parker-research/yagi-flower-antenna/README.md

# yagi-flower-antenna

A group of UHF yagi antennas, arranged in a flower pattern and connected with a SP8T RF switch, to enable coarse beam direction control (like an antenna rotator, but solid-state).

The technical name for this not-all-that-novel approach is "faceted/switched-element array".

## Status

In development. Expected completion: 2026-12-01.

## Parts

1. Antennas (6x yagi antennas, approx. 7 dBi each)
2. Structural mount for antennas (see [`mechanical/`](mechanical/README.md))
3. SP8T RF switch PCB
    - Microcontroller
    - SP8T RF switch IC (SKY13418)
    - LNAs between each antenna port and the RF switch
    - SMA ports to each antenna + common
    - 3D-printed enclosure (see [`mechanical/`](mechanical/README.md))
4. Firmware for PCB microcontroller, masquerading as an antenna rotator (see [`firmware/`](firmware/README.md))
5. Cables to each antenna

## Why?

Satellite tracking works best with a directional antenna: less ambient noise/interference, and higher gain.

However, mechanical antenna rotators are expensive and wear out over time. They require zeroing/calibration, especially after power outages. There are no high-quality open source/DIY designs available. Cheap rotators (e.g., AntRunner) fail in weatherproofing.

This project aims to solve these problems by providing a low-cost, high-quality, open source/DIY, solid-state replacement for a traditional mechanical antenna rotator.

Consider an antenna being deployed in a remote location, like the arctic. As far as I can tell, this yagi flower antenna is ideal for such a deployment. And, an omnidirectional antenna might be almost as much work to build as this project is.

## Features

- Downlink-only
- Presents itself as a traditional antenna rotator, ensuring compatibility with existing antenna rotator software (e.g., SatNOGS Client, GPredict)
- Solid-state (no moving parts) adds reliability and durability for harsh environments

## Related Projects

### Research Papers

- "Concept of 3D Antenna Array for Sub-GHz Rotator-Less Small Satellite Ground Stations and Advanced IoT Gateways": https://www.mdpi.com/2673-4001/6/4/92 / https://doi.org/10.3390/telecom6040092
