parker-research/yagi-flower-antenna/Antenna-Array-Switch-PCB/Antenna-Array-Switch-PCB.kicad_pcb

## KiCad design Antenna-Array-Switch-PCB/Antenna-Array-Switch-PCB.kicad_pcb (2026-10-21)

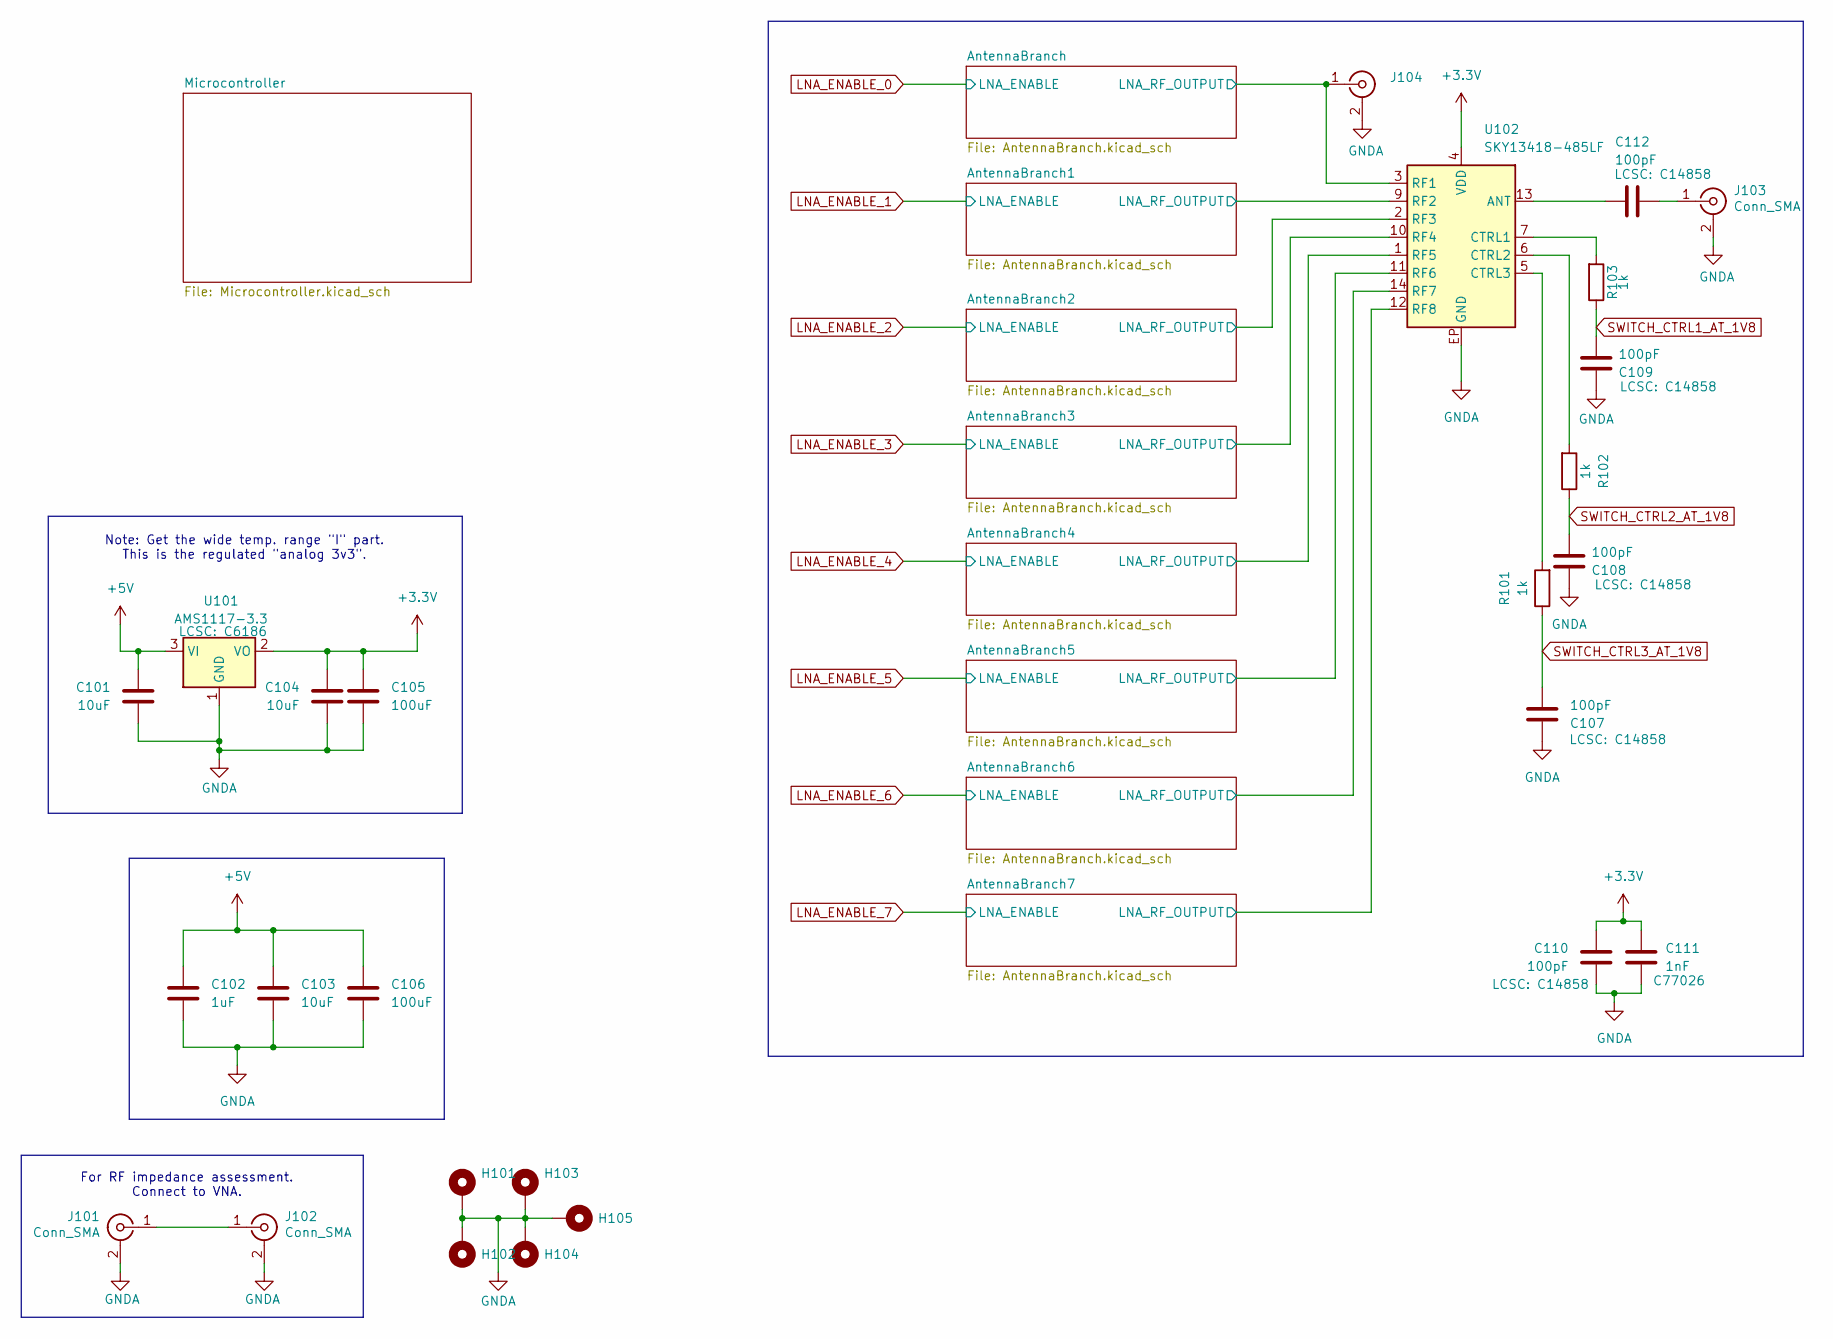
[picture p4: schematic Antenna-Array-Switch-PCB.kicad_sch]

Parts:
C101, C103, C104: 10uF; C_1206_3216Metric_Pad1.33x1.80mm_HandSolder
C102: 1uF; C_0603_1608Metric_Pad1.08x0.95mm_HandSolder
C105, C106: 100uF; C_1206_3216Metric_Pad1.33x1.80mm_HandSolder
C107, C108, C109, C110, C112: 100pF; C_0603_1608Metric_Pad1.08x0.95mm_HandSolder; LCSC C14858
C111: 1nF; C_0603_1608Metric_Pad1.08x0.95mm_HandSolder; LCSC C77026
H101, H102, H103, H104, H105: MountingHole_Pad; MountingHole_3.2mm_M3_Pad
J101, J102, J103: Conn_SMA; SMA_Amphenol_901-144_Vertical
J104: Conn_Coaxial; SMA_Amphenol_901-144_Vertical
R101, R102, R103: 1k; R_0603_1608Metric_Pad0.98x0.95mm_HandSolder
U101: AMS1117-3.3; SOT-223-3_TabPin2; LCSC C6186
U102: SKY13418-485LF; Skyworks_QFN-14-1EP_2x2mm_SKY13418_Handsolder; LCSC C150871

Connections:
+3.3V: C104.1, C105.1, C110.2, C111.2, U101.2 (VO), U102.4 (VDD)
+5V: C101.1, C102.1, C103.1, C106.1, U101.3 (VI); also elsewhere on the board
/AntennaBranch1/LNA_RF_OUTPUT: U102.9 (RF2); also elsewhere on the board
/AntennaBranch2/LNA_RF_OUTPUT: U102.2 (RF3); also elsewhere on the board
/AntennaBranch3/LNA_RF_OUTPUT: U102.10 (RF4); also elsewhere on the board
/AntennaBranch4/LNA_RF_OUTPUT: U102.1 (RF5); also elsewhere on the board
/AntennaBranch5/LNA_RF_OUTPUT: U102.11 (RF6); also elsewhere on the board
/AntennaBranch6/LNA_RF_OUTPUT: U102.14 (RF7); also elsewhere on the board
/AntennaBranch7/LNA_RF_OUTPUT: U102.12 (RF8); also elsewhere on the board
/AntennaBranch/LNA_RF_OUTPUT: J104.1 (In), U102.3 (RF1); also elsewhere on the board
GNDA: C101.2, C102.2, C103.2, C104.2, C105.2, C106.2, C107.2, C108.2, C109.2, C110.1, C111.1, H101.1 (1_1), H102.1 (1_1), H103.1 (1_1), H104.1 (1_1), H105.1 (1_1), J101.2 (Ext), J102.2 (Ext), J103.2 (Ext), J104.2 (Ext), U101.1 (GND), U102.EP (GND); also elsewhere on the board
unnamed: J101.1 (In), J102.1 (In)
unnamed: C112.1, J103.1 (In)
unnamed: C112.2, U102.13 (ANT)
unnamed: R103.2, U102.7 (CTRL1)
unnamed: R102.2, U102.6 (CTRL2)
unnamed: R101.2, U102.5 (CTRL3)
SWITCH_CTRL1_AT_1V8: C109.1, R103.1; also elsewhere on the board
SWITCH_CTRL2_AT_1V8: C108.1, R102.1; also elsewhere on the board
SWITCH_CTRL3_AT_1V8: C107.1, R101.1; also elsewhere on the board

Notes on the sheet:
For RF impedance assessment. Connect to VNA.
Note: Get the wide temp. range "I" part. This is the regulated "analog 3v3".

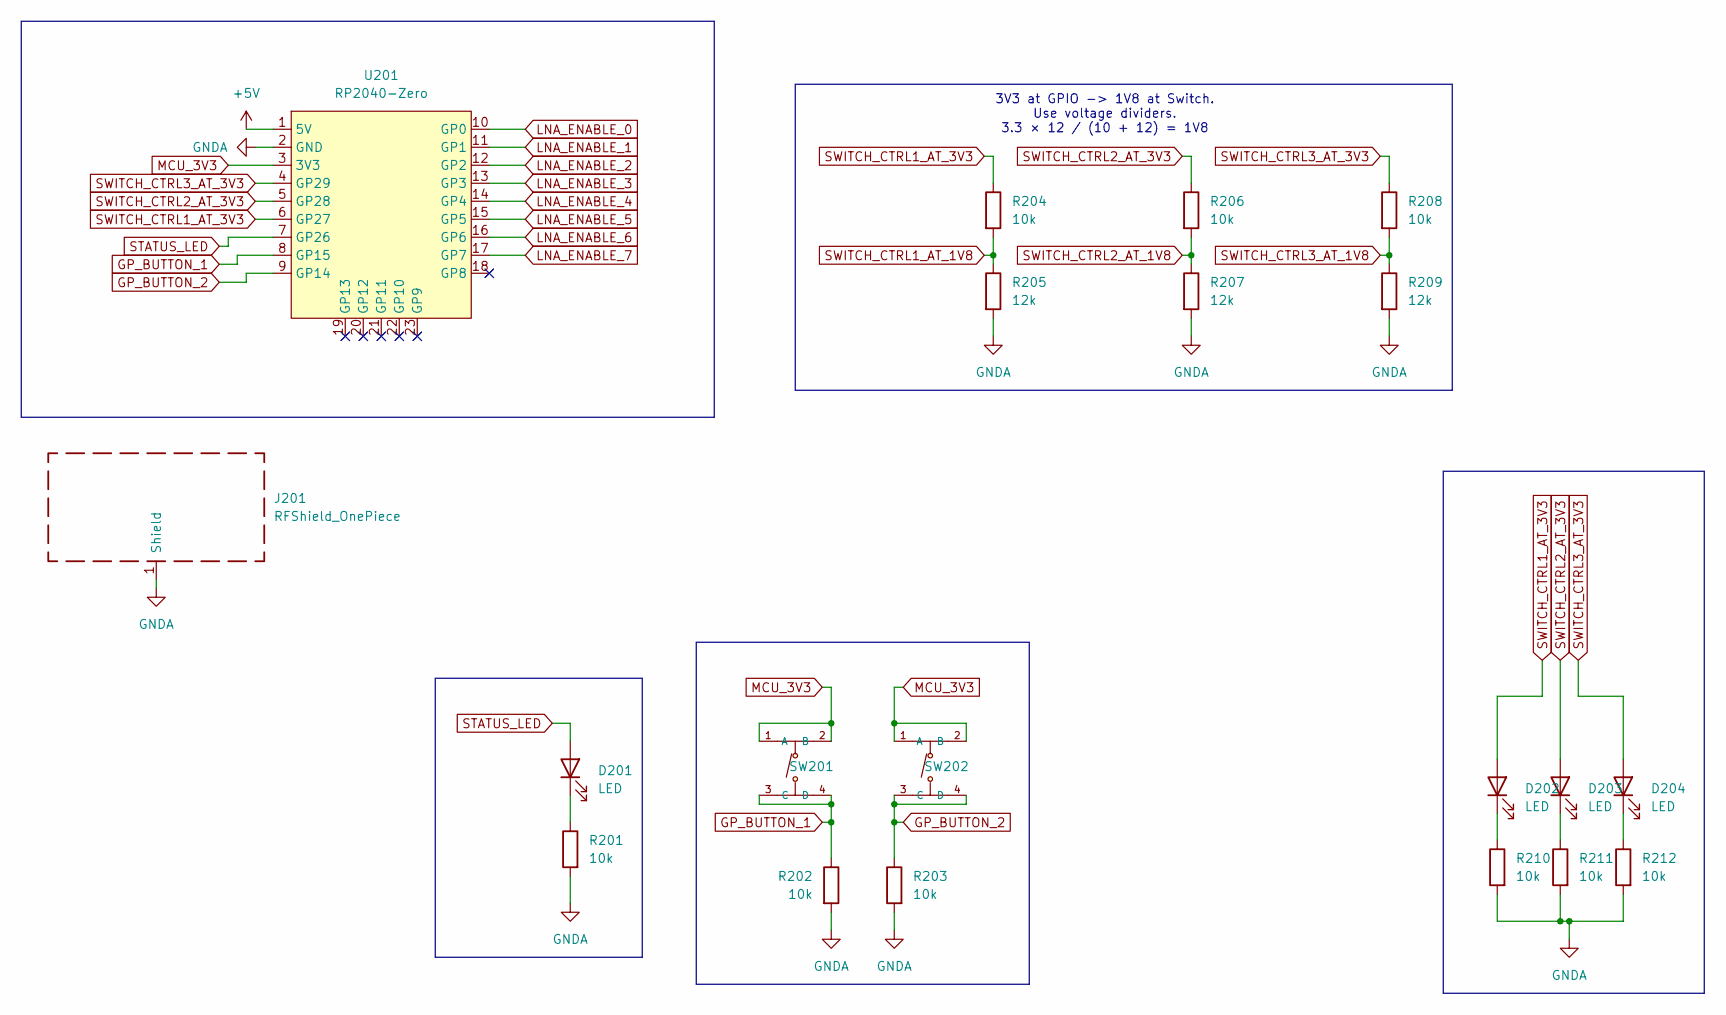
[picture p5: schematic Microcontroller.kicad_sch]

Parts:
D201, D202, D203, D204: LED; LED_0603_1608Metric_Pad1.05x0.95mm_HandSolder
J201: RFShield_OnePiece; Wuerth_36103305_30x30mm
R201, R202, R203, R204, R206, R208, R210, R211, R212: 10k; R_0603_1608Metric_Pad0.98x0.95mm_HandSolder
R205, R207, R209: 12k; R_0603_1608Metric_Pad0.98x0.95mm_HandSolder
SW201, SW202: TS-1187A-B-A-B; C318884_SW-SMD_4P-L5_1-W5_1-P3_70-LS6_5-TL_H1_5; LCSC C318884
U201: RP2040-Zero; RP2040 Zero

Connections:
+5V: U201.1 (5V); also elsewhere on the board
GNDA: J201.1 (Shield_1), R201.2, R202.2, R203.2, R205.2, R207.2, R209.2, R210.2, R211.2, R212.2, U201.2 (GND); also elsewhere on the board
GP_BUTTON_1: R202.1, SW201.3 (C), SW201.4 (D), U201.8 (GP15)
GP_BUTTON_2: R203.1, SW202.3 (C), SW202.4 (D), U201.9 (GP14)
LNA_ENABLE_0: U201.10 (GP0); also elsewhere on the board
LNA_ENABLE_1: U201.11 (GP1); also elsewhere on the board
LNA_ENABLE_2: U201.12 (GP2); also elsewhere on the board
LNA_ENABLE_3: U201.13 (GP3); also elsewhere on the board
LNA_ENABLE_4: U201.14 (GP4); also elsewhere on the board
LNA_ENABLE_5: U201.15 (GP5); also elsewhere on the board
LNA_ENABLE_6: U201.16 (GP6); also elsewhere on the board
LNA_ENABLE_7: U201.17 (GP7); also elsewhere on the board
MCU_3V3: SW201.1 (A), SW201.2 (B), SW202.1 (A), SW202.2 (B), U201.3 (3V3)
unnamed: D201.1 (K), R201.1
unnamed: D202.1 (K), R210.1
unnamed: D203.1 (K), R211.1
unnamed: D204.1 (K), R212.1
STATUS_LED: D201.2 (A), U201.7 (GP26)
SWITCH_CTRL1_AT_1V8: R204.2, R205.1; also elsewhere on the board
SWITCH_CTRL1_AT_3V3: D202.2 (A), R204.1, U201.6 (GP27)
SWITCH_CTRL2_AT_1V8: R206.2, R207.1; also elsewhere on the board
SWITCH_CTRL2_AT_3V3: D203.2 (A), R206.1, U201.5 (GP28)
SWITCH_CTRL3_AT_1V8: R208.2, R209.1; also elsewhere on the board
SWITCH_CTRL3_AT_3V3: D204.2 (A), R208.1, U201.4 (GP29)

Notes on the sheet:
3V3 at GPIO -> 1V8 at Switch. Use voltage dividers. 3.3 × 12 / (10 + 12) = 1V8

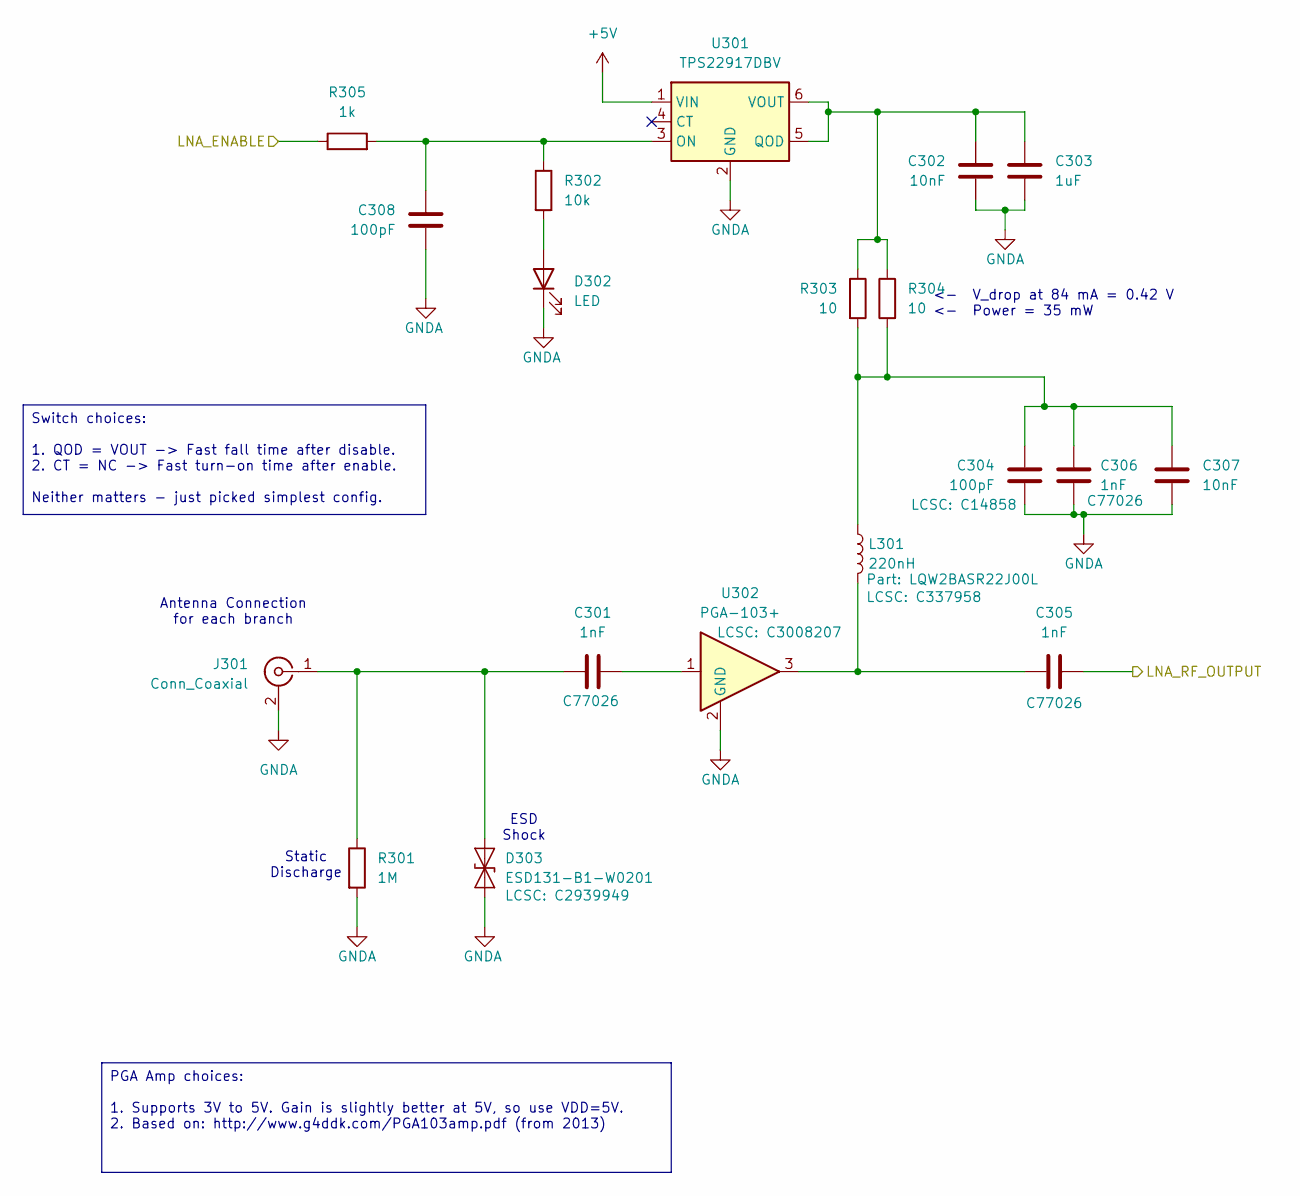
[picture p6: schematic AntennaBranch.kicad_sch]

Parts:
C301, C305, C306: 1nF; C_0603_1608Metric_Pad1.08x0.95mm_HandSolder; LCSC C77026
C302, C307: 10nF; C_0603_1608Metric_Pad1.08x0.95mm_HandSolder
C303: 1uF; C_0603_1608Metric_Pad1.08x0.95mm_HandSolder
C304: 100pF; C_0603_1608Metric_Pad1.08x0.95mm_HandSolder; LCSC C14858
C308: 100pF; C_0603_1608Metric_Pad1.08x0.95mm_HandSolder
D302: LED; LED_0603_1608Metric_Pad1.05x0.95mm_HandSolder
D303: ESD131-B1-W0201; Infineon_SG-WLL-2-3_0.58x0.28_P0.36mm; LCSC C2939949
J301: Conn_Coaxial; SMA_Amphenol_901-144_Vertical
L301: 220nH; L_0805_2012Metric_Pad1.05x1.20mm_HandSolder; Part LQW2BASR22J00L; LCSC C337958
R301: 1M; R_0603_1608Metric_Pad0.98x0.95mm_HandSolder
R302: 10k; R_0603_1608Metric_Pad0.98x0.95mm_HandSolder
R303, R304: 10; R_0603_1608Metric_Pad0.98x0.95mm_HandSolder
R305: 1k; R_0603_1608Metric_Pad0.98x0.95mm_HandSolder
U301: TPS22917DBV; SOT-23-6
U302: PGA-103+; SOT-89-3; LCSC C3008207

Connections:
+5V: U301.1 (VIN); also elsewhere on the board
/AntennaBranch/LNA_RF_OUTPUT: C305.2; also elsewhere on the board
GNDA: C302.1, C303.1, C304.1, C306.1, C307.1, C308.1, D302.1 (K), D303.1 (A1), J301.2 (Ext), R301.2, U301.2 (GND), U302.2 (GND_2); also elsewhere on the board
LNA_ENABLE_0: R305.1; also elsewhere on the board
unnamed: C301.2, U302.1
unnamed: C304.2, C306.2, C307.2, L301.1, R303.2, R304.2
unnamed: C305.1, L301.2, U302.3
unnamed: D302.2 (A), R302.2
unnamed: C301.1, D303.2 (A2), J301.1 (In), R301.1
unnamed: C308.2, R302.1, R305.2, U301.3 (ON)
unnamed: C302.2, C303.2, R303.1, R304.1, U301.5 (QOD), U301.6 (VOUT)

Parts of its further copies:
C401, C405, C406, C501, C505, C506, C601, C605, C606, C701, C705, C706, C801, C805, C806, C901, C905, C906, C1001, C1005, C1006: 1nF; C_0603_1608Metric_Pad1.08x0.95mm_HandSolder; LCSC C77026
C402, C407, C502, C507, C602, C607, C702, C707, C802, C807, C902, C907, C1002, C1007: 10nF; C_0603_1608Metric_Pad1.08x0.95mm_HandSolder
C403, C503, C603, C703, C803, C903, C1003: 1uF; C_0603_1608Metric_Pad1.08x0.95mm_HandSolder
C404, C504, C604, C704, C804, C904, C1004: 100pF; C_0603_1608Metric_Pad1.08x0.95mm_HandSolder; LCSC C14858
C408, C508, C608, C708, C808, C908, C1008: 100pF; C_0603_1608Metric_Pad1.08x0.95mm_HandSolder
D402, D502, D602, D702, D802, D902, D1002: LED; LED_0603_1608Metric_Pad1.05x0.95mm_HandSolder
D403, D503, D603, D703, D803, D903, D1003: ESD131-B1-W0201; Infineon_SG-WLL-2-3_0.58x0.28_P0.36mm; LCSC C2939949
J401, J501, J601, J701, J801, J901, J1001: Conn_Coaxial; SMA_Amphenol_901-144_Vertical
L401, L501, L601, L701, L801, L901, L1001: 220nH; L_0805_2012Metric_Pad1.05x1.20mm_HandSolder; Part LQW2BASR22J00L; LCSC C337958
R401, R501, R601, R701, R801, R901, R1001: 1M; R_0603_1608Metric_Pad0.98x0.95mm_HandSolder
R402, R502, R602, R702, R802, R902, R1002: 10k; R_0603_1608Metric_Pad0.98x0.95mm_HandSolder
R403, R404, R503, R504, R603, R604, R703, R704, R803, R804, R903, R904, R1003, R1004: 10; R_0603_1608Metric_Pad0.98x0.95mm_HandSolder
R405, R505, R605, R705, R805, R905, R1005: 1k; R_0603_1608Metric_Pad0.98x0.95mm_HandSolder
U401, U501, U601, U701, U801, U901, U1001: TPS22917DBV; SOT-23-6
U402, U502, U602, U702, U802, U902, U1002: PGA-103+; SOT-89-3; LCSC C3008207

Connections of its further copies:
+5V: U401.1 (VIN), U501.1 (VIN), U601.1 (VIN), U701.1 (VIN), U801.1 (VIN), U901.1 (VIN), U1001.1 (VIN); also elsewhere on the board
/AntennaBranch1/LNA_RF_OUTPUT: C405.2; also elsewhere on the board
/AntennaBranch2/LNA_RF_OUTPUT: C505.2; also elsewhere on the board
/AntennaBranch3/LNA_RF_OUTPUT: C605.2; also elsewhere on the board
/AntennaBranch4/LNA_RF_OUTPUT: C705.2; also elsewhere on the board
/AntennaBranch5/LNA_RF_OUTPUT: C805.2; also elsewhere on the board
/AntennaBranch6/LNA_RF_OUTPUT: C905.2; also elsewhere on the board
/AntennaBranch7/LNA_RF_OUTPUT: C1005.2; also elsewhere on the board
GNDA: C402.1, C403.1, C404.1, C406.1, C407.1, C408.1, C502.1, C503.1, C504.1, C506.1, C507.1, C508.1, C602.1, C603.1, C604.1, C606.1, C607.1, C608.1, C702.1, C703.1, C704.1, C706.1, C707.1, C708.1, C802.1, C803.1, C804.1, C806.1, C807.1, C808.1, C902.1, C903.1, C904.1, C906.1, C907.1, C908.1, C1002.1, C1003.1, C1004.1, C1006.1, C1007.1, C1008.1, D402.1 (K), D403.1 (A1), D502.1 (K), D503.1 (A1), D602.1 (K), D603.1 (A1), D702.1 (K), D703.1 (A1), D802.1 (K), D803.1 (A1), D902.1 (K), D903.1 (A1), D1002.1 (K), D1003.1 (A1), J401.2 (Ext), J501.2 (Ext), J601.2 (Ext), J701.2 (Ext), J801.2 (Ext), J901.2 (Ext), J1001.2 (Ext), R401.2, R501.2, R601.2, R701.2, R801.2, R901.2, R1001.2, U401.2 (GND), U402.2 (GND_2), U501.2 (GND), U502.2 (GND_2), U601.2 (GND), U602.2 (GND_2), U701.2 (GND), U702.2 (GND_2), U801.2 (GND), U802.2 (GND_2), U901.2 (GND), U902.2 (GND_2), U1001.2 (GND), U1002.2 (GND_2); also elsewhere on the board
LNA_ENABLE_1: R405.1; also elsewhere on the board
LNA_ENABLE_2: R505.1; also elsewhere on the board
LNA_ENABLE_3: R605.1; also elsewhere on the board
LNA_ENABLE_4: R705.1; also elsewhere on the board
LNA_ENABLE_5: R805.1; also elsewhere on the board
LNA_ENABLE_6: R905.1; also elsewhere on the board
LNA_ENABLE_7: R1005.1; also elsewhere on the board
unnamed: C401.2, U402.1
unnamed: C404.2, C406.2, C407.2, L401.1, R403.2, R404.2
unnamed: C405.1, L401.2, U402.3
unnamed: C501.2, U502.1
unnamed: C504.2, C506.2, C507.2, L501.1, R503.2, R504.2
unnamed: C505.1, L501.2, U502.3
unnamed: C601.2, U602.1
unnamed: C604.2, C606.2, C607.2, L601.1, R603.2, R604.2
unnamed: C605.1, L601.2, U602.3
unnamed: C701.2, U702.1
unnamed: C704.2, C706.2, C707.2, L701.1, R703.2, R704.2
unnamed: C705.1, L701.2, U702.3
unnamed: C801.2, U802.1
unnamed: C804.2, C806.2, C807.2, L801.1, R803.2, R804.2
unnamed: C805.1, L801.2, U802.3
unnamed: C901.2, U902.1
unnamed: C904.2, C906.2, C907.2, L901.1, R903.2, R904.2
unnamed: C905.1, L901.2, U902.3
unnamed: C1001.2, U1002.1
unnamed: C1004.2, C1006.2, C1007.2, L1001.1, R1003.2, R1004.2
unnamed: C1005.1, L1001.2, U1002.3
unnamed: D402.2 (A), R402.2
unnamed: C401.1, D403.2 (A2), J401.1 (In), R401.1
unnamed: D502.2 (A), R502.2
unnamed: C501.1, D503.2 (A2), J501.1 (In), R501.1
unnamed: D602.2 (A), R602.2
unnamed: C601.1, D603.2 (A2), J601.1 (In), R601.1
unnamed: D702.2 (A), R702.2
unnamed: C701.1, D703.2 (A2), J701.1 (In), R701.1
unnamed: D802.2 (A), R802.2
unnamed: C801.1, D803.2 (A2), J801.1 (In), R801.1
unnamed: D902.2 (A), R902.2
unnamed: C901.1, D903.2 (A2), J901.1 (In), R901.1
unnamed: D1002.2 (A), R1002.2
unnamed: C1001.1, D1003.2 (A2), J1001.1 (In), R1001.1
unnamed: C408.2, R402.1, R405.2, U401.3 (ON)
unnamed: C402.2, C403.2, R403.1, R404.1, U401.5 (QOD), U401.6 (VOUT)
unnamed: C508.2, R502.1, R505.2, U501.3 (ON)
unnamed: C502.2, C503.2, R503.1, R504.1, U501.5 (QOD), U501.6 (VOUT)
unnamed: C608.2, R602.1, R605.2, U601.3 (ON)
unnamed: C602.2, C603.2, R603.1, R604.1, U601.5 (QOD), U601.6 (VOUT)
unnamed: C708.2, R702.1, R705.2, U701.3 (ON)
unnamed: C702.2, C703.2, R703.1, R704.1, U701.5 (QOD), U701.6 (VOUT)
unnamed: C808.2, R802.1, R805.2, U801.3 (ON)
unnamed: C802.2, C803.2, R803.1, R804.1, U801.5 (QOD), U801.6 (VOUT)
unnamed: C908.2, R902.1, R905.2, U901.3 (ON)
unnamed: C902.2, C903.2, R903.1, R904.1, U901.5 (QOD), U901.6 (VOUT)
unnamed: C1008.2, R1002.1, R1005.2, U1001.3 (ON)
unnamed: C1002.2, C1003.2, R1003.1, R1004.1, U1001.5 (QOD), U1001.6 (VOUT)

Notes on the sheet:
Static Discharge
<- V_drop at 84 mA = 0.42 V <- Power = 35 mW
ESD Shock
Antenna Connection for each branch
Switch choices: 1. QOD = VOUT -> Fast fall time after disable. 2. CT = NC -> Fast turn-on time after enable. Neither matters - just picked simplest config.
PGA Amp choices: 1. Supports 3V to 5V. Gain is slightly better at 5V, so use VDD=5V. 2. Based on: http://www.g4ddk.com/PGA103amp.pdf (from 2013)

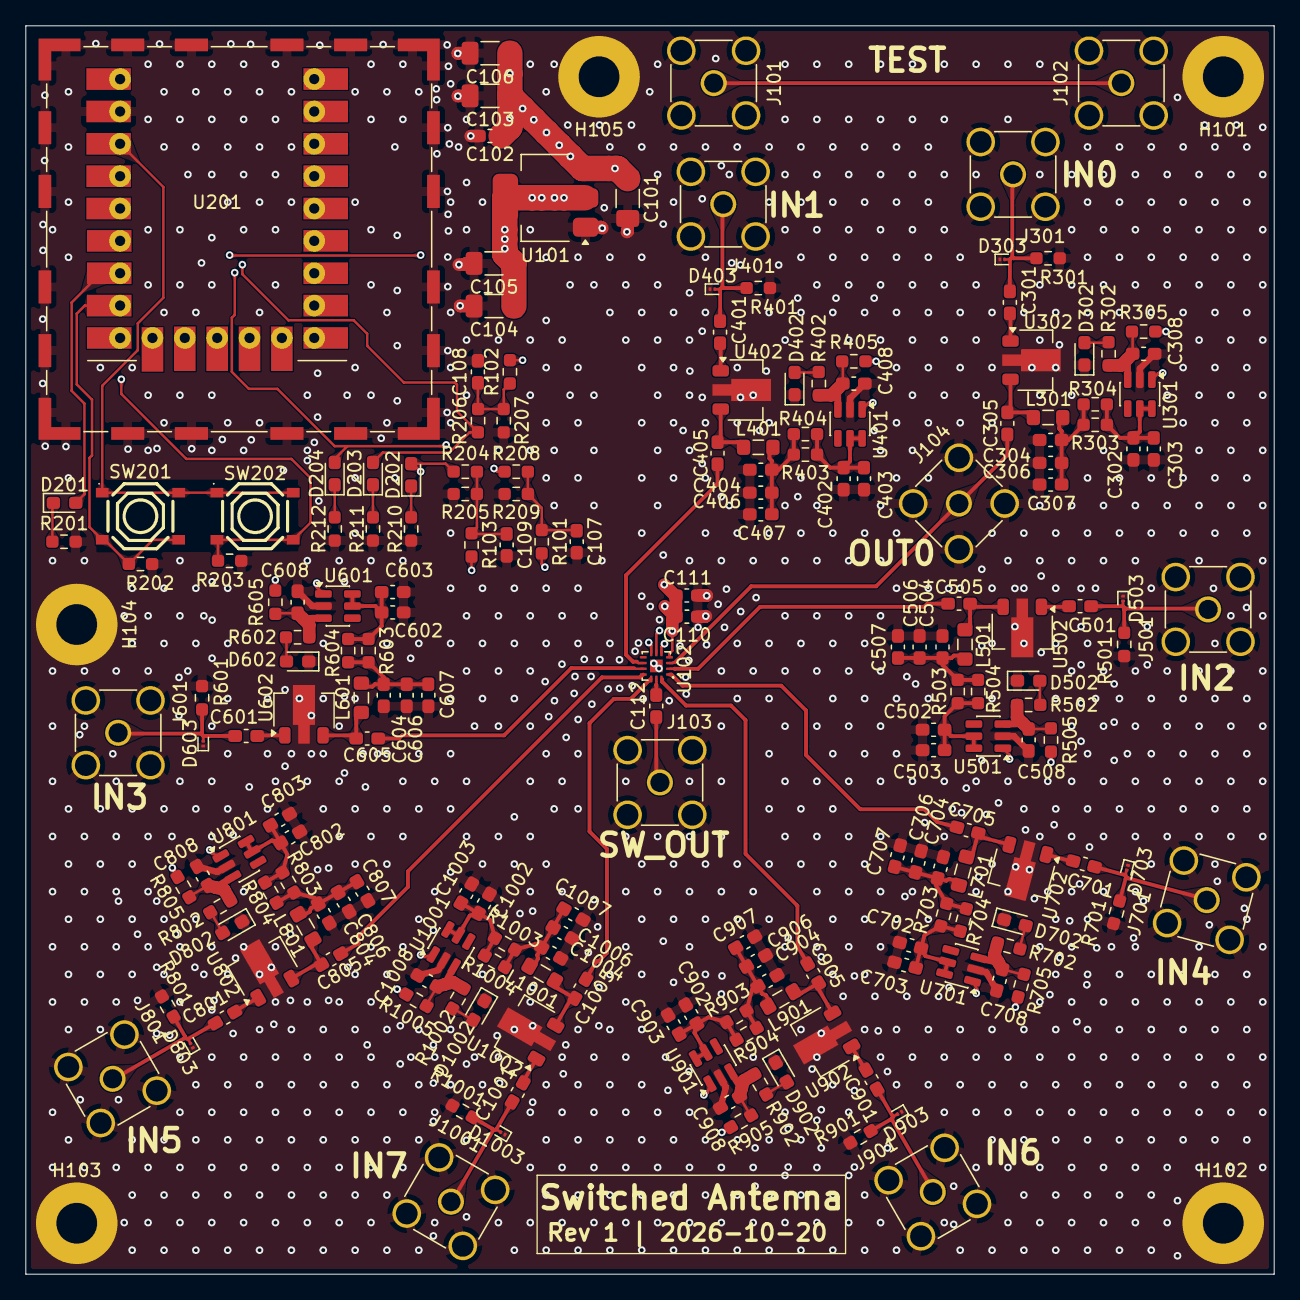
[picture p7: board Antenna-Array-Switch-PCB.kicad_pcb from above]

Board: 4 copper layers, 98.0 x 98.0 mm, 198 parts (0 on the bottom side), 95 nets.
