parker-research/yagi-flower-antenna/firmware/antenna_config.c

#include "antenna_config.h"

// TODO: Placeholder layout. Update to match the as-built structure.
// Six yagis around the compass, tilted up, plus two QFH fallbacks.
const antenna_config_antenna_t antenna_config_ports[BOARD_PORT_COUNT] = {
    //  name           type                           az     el    bw_h  bw_v
    { "Yagi N",   ANTENNA_CONFIG_TYPE_DIRECTIONAL,   0.0f, 35.0f, 70.0f, 60.0f }, // Port 0
    { "Yagi NE",  ANTENNA_CONFIG_TYPE_DIRECTIONAL,  60.0f, 35.0f, 70.0f, 60.0f }, // Port 1
    { "Yagi SE",  ANTENNA_CONFIG_TYPE_DIRECTIONAL, 120.0f, 35.0f, 70.0f, 60.0f }, // Port 2
    { "Yagi S",   ANTENNA_CONFIG_TYPE_DIRECTIONAL, 180.0f, 35.0f, 70.0f, 60.0f }, // Port 3
    { "Yagi SW",  ANTENNA_CONFIG_TYPE_DIRECTIONAL, 240.0f, 35.0f, 70.0f, 60.0f }, // Port 4
    { "Yagi NW",  ANTENNA_CONFIG_TYPE_DIRECTIONAL, 300.0f, 35.0f, 70.0f, 60.0f }, // Port 5
    { "QFH N",    ANTENNA_CONFIG_TYPE_OMNI,          0.0f, 60.0f,  0.0f,  0.0f }, // Port 6
    { "QFH S",    ANTENNA_CONFIG_TYPE_OMNI,        180.0f, 60.0f,  0.0f,  0.0f }, // Port 7
};

// Default/init port on startup, until commanded with Az/El directive.
const unsigned antenna_config_default_port = 0;

const char *antenna_config_type_name(antenna_config_type_t type) {
    switch (type) {
        case ANTENNA_CONFIG_TYPE_NONE:        return "none";
        case ANTENNA_CONFIG_TYPE_DIRECTIONAL: return "directional";
        case ANTENNA_CONFIG_TYPE_OMNI:        return "omni";
    }
    return "unknown";
}
