parker-research/yagi-flower-antenna/(commit log)

2026-10-16 Create KiCAD project
    [Antenna-Array-Switch-PCB.kicad_pcb, Antenna-Array-Switch-PCB.kicad_sch]
2026-10-16 PCB: Draw LNA circuit
    [Antenna-Array-Switch-PCB.kicad_sch, AntennaBranch.kicad_sch, Microcontroller.kicad_sch]
2026-10-16 PCB: Assign footprints where sensible
    [Antenna-Array-Switch-PCB.kicad_sch, AntennaBranch.kicad_sch]
2026-10-16 PCB: Create symbol and footprint libraries
2026-10-16 PCB: Create SKY13418 symbol and footprint
2026-10-17 PCB: Add MCU, switch
    [Antenna-Array-Switch-PCB.kicad_sch, AntennaBranch.kicad_sch, Microcontroller.kicad_sch]
2026-10-17 PCB: Assign footprints
    [Antenna-Array-Switch-PCB.kicad_sch, Microcontroller.kicad_sch]
2026-10-17 PCB: Finish footprint assignments
    [Antenna-Array-Switch-PCB.kicad_pcb, Microcontroller.kicad_sch]
2026-10-17 PCB: Layout an LNA segment
    [Antenna-Array-Switch-PCB.kicad_pcb, Antenna-Array-Switch-PCB.kicad_sch, AntennaBranch.kicad_sch]
2026-10-17 PCB, Docs: Layout, stackup, shielding
    [Antenna-Array-Switch-PCB.kicad_pcb, Antenna-Array-Switch-PCB.kicad_sch, AntennaBranch.kicad_sch, Microcontroller.kicad_sch]
2026-10-17 PCB: Layout - position connectors for autoplacement
    [Antenna-Array-Switch-PCB.kicad_pcb, Antenna-Array-Switch-PCB.kicad_sch]
2026-10-17 PCB: Replicate layouts to all LNA chains
    [Antenna-Array-Switch-PCB.kicad_pcb, Antenna-Array-Switch-PCB.kicad_sch, AntennaBranch.kicad_sch, Microcontroller.kicad_sch]
2026-10-17 PCB Sch: Add filters at control lines
    [Antenna-Array-Switch-PCB.kicad_pcb, Antenna-Array-Switch-PCB.kicad_sch, AntennaBranch.kicad_sch]
2026-10-17 PCB: More layout, legends
    [Antenna-Array-Switch-PCB.kicad_pcb, Antenna-Array-Switch-PCB.kicad_sch, Microcontroller.kicad_sch]
2026-10-17 PCB: Add sticking vias and teardrops
    [Antenna-Array-Switch-PCB.kicad_pcb]
2026-10-20 PCB: Export production files
    [Antenna-Array-Switch-PCB.kicad_pcb]
2026-10-20 PCB: Update LCSC assignments for ordering
    [Antenna-Array-Switch-PCB.kicad_pcb, Antenna-Array-Switch-PCB.kicad_sch, AntennaBranch.kicad_sch]
2026-10-20 PCB: Minor updates
    [Antenna-Array-Switch-PCB.kicad_pcb, Antenna-Array-Switch-PCB.kicad_sch]
2026-10-20 PCB: Minor review updates - vias, DC block on switch output
    [Antenna-Array-Switch-PCB.kicad_pcb, Antenna-Array-Switch-PCB.kicad_sch]
2026-10-21 PCB: Resave
    [Antenna-Array-Switch-PCB.kicad_pcb]
2026-10-21 PCB: Update regulator to JLC Basic part
    [Antenna-Array-Switch-PCB.kicad_pcb, Antenna-Array-Switch-PCB.kicad_sch]
2026-10-21 docs: Minor PCB design notes and README
2026-10-21 PCB: Fix bad trace width on RF output stub
    [Antenna-Array-Switch-PCB.kicad_pcb, Antenna-Array-Switch-PCB.kicad_sch]
2026-11-09 Create PCB enclosure
2026-11-09 Enclosure: Re-shape a bit
2026-11-09 Enclosure: Fix mounting/closure technique
2026-11-09 Enclosure: Include IN4 in assembly
2026-11-09 Enclosure: Enable more ports, USB-C placement
2026-11-09 Enclosure: Remove SMA square cutouts
2026-11-10 Enclosure: Fix readability of port labels
2026-11-10 FW: Update Antenna Config defaults/docs
2026-11-10 Enclosure: Move CAD into a mechanical folder
2026-11-10 Frame: Initial antenna frame CAD
2026-11-10 Frame: Move booms to the top-side of bowl
2026-11-10 Frame: Render elements
2026-11-10 Frame: Spread arms out
2026-11-10 Frame: Pin to Rc=0.7*wavelength - usable
